Maitresinh/RDV4-a-simpler-yet-complete-laser-harp/GALVO_PURCHASE.md

# Choix du galvo

Acheter un kit complet, pas un moteur nu.

## Exigences

- boucle fermée ;
- 20 kpps minimum ;
- support mécanique inclus ;
- moteurs, deux drivers et alimentation appariés ;
- miroir adapté au rouge 650 nm ;
- schéma ou sérigraphie claire des entrées ;
- entrée X exploitable en simple-ended ou convertisseur différentiel documenté.

## À éviter

- galvo open-loop ;
- moteur de graveur ;
- scanner résonant ;
- driver sans alimentation ;
- annonce sans photo des connecteurs ;
- vitesse annoncée sans angle de référence.

## Informations à relever dès réception

- tension des alimentations ;
- tension d'entrée pleine échelle ;
- entrée simple ou différentielle ;
- brochage des connecteurs ;
- dimension et entraxe du bloc XY ;
- position neutre des miroirs ;
- méthode de maintien de l'axe Y au centre.
