Maitresinh/RDV4-a-simpler-yet-complete-laser-harp/hardware/kicad/RDV4_wiring.sch

## KiCad design hardware/kicad/RDV4_wiring.sch (2026-07-14)

Schematic: RDV4_wiring.sch

Parts:
C1: 100NF
D1: STATUS_LED
J1: TEENSY_4.0
J2: MCP4822_MODULE
J3: OPT101_MODULE
J4: VL53L4CD_MODULE
J5: LASER_650NM_TTL
J6: DUAL_BIPOLAR_INTERFACE
J7: GALVO_XY_DRIVER_INPUTS
J8: AUX_5V_INPUT
R1: 1K
R2: 10K
R3: 12K
R4: 22K
R6: 330R
SW1: E_STOP_NC
SW2: LID_NC
SW3: ARM

Notes on the sheet:
LOGIC / MIDI / SENSORS
LASER SAFETY AND GALVO
J2 pin 6 = LDAC -> GND VOUTA = X, VOUTB = Y neutral
Both switches wired using normally-closed contacts
J6 is a dual-channel 0..2.048 V to bipolar converter. Set X center and Y neutral to 0 V. Begin at +/-0.5 V. Do not ground differential inputs unless the driver manual permits it.
POWER / GROUND RULES
Teensy is powered by USB. Sensors and DAC use 3.3 V. Laser uses the safe 5 V chain. Galvo drivers and bipolar interface use their documented supplies. Keep power wiring away from OPT101. Connect signal grounds at one star point only when the galvo interface manual allows single-ended operation.
