Maitresinh/RDV4-a-simpler-yet-complete-laser-harp/firmware/include/config.h

#pragma once
#include <Arduino.h>

#ifndef ENABLE_HEIGHT_SENSOR
#define ENABLE_HEIGHT_SENSOR 1
#endif

#ifndef ENABLE_DIAGNOSTICS
#define ENABLE_DIAGNOSTICS 0
#endif

namespace cfg {

constexpr uint8_t PIN_ARM = 2;
constexpr uint8_t PIN_INTERLOCK_MON = 3;
constexpr uint8_t PIN_LASER_TTL = 6;
constexpr uint8_t PIN_STATUS_LED = 7;
constexpr uint8_t PIN_DAC_CS = 10;
constexpr uint8_t PIN_PHOTO = A1;

constexpr bool LASER_ACTIVE_HIGH = true;
constexpr bool HEIGHT_SENSOR_REQUIRED = true;
constexpr uint8_t MIDI_CHANNEL = 1;
constexpr uint8_t BASE_NOTE = 60; // C4, puis offsets -12/0/+12/+24
constexpr uint8_t MIDI_VELOCITY = 100;

constexpr uint16_t DAC_CENTER = 2048;
constexpr uint16_t DAC_Y_CENTER = 2048; // canal B, axe Y maintenu au neutre
constexpr uint16_t DAC_MIN = 1848;
constexpr uint16_t DAC_MAX = 2248;
constexpr uint32_t DAC_SPI_HZ = 20000000;

constexpr uint16_t GALVO_SETTLE_US = 90;
constexpr uint16_t LASER_RISE_US = 10;
constexpr uint16_t VISIBLE_DWELL_US = 22;
constexpr uint8_t ADC_SAMPLES_AMBIENT = 2;
constexpr uint8_t ADC_SAMPLES_LIT = 2;

constexpr uint8_t ATTACK_CONFIRM_FRAMES = 1;
constexpr uint8_t RELEASE_CONFIRM_FRAMES = 2;
constexpr uint8_t BASELINE_EMA_SHIFT = 5;
constexpr uint8_t BASELINE_WARMUP_SHIFT = 2;
constexpr uint16_t BASELINE_WARMUP_FRAMES = 32;

constexpr int16_t PER_BEAM_ON_DELTA[12] = {
  80,80,80,80,80,80,80,80,80,80,80,80
};
constexpr int16_t PER_BEAM_OFF_DELTA[12] = {
  48,48,48,48,48,48,48,48,48,48,48,48
};

constexpr uint16_t HEIGHT_MIN_MM = 80;
constexpr uint16_t HEIGHT_MAX_MM = 1100;
constexpr uint16_t HEIGHT_BOUNDARIES_MM[3] = {280, 520, 780};
constexpr int8_t HEIGHT_OCTAVE_SEMITONES[4] = {-12, 0, 12, 24};
constexpr uint16_t HEIGHT_HYSTERESIS_MM = 35;
constexpr uint32_t HEIGHT_TIMEOUT_MS = 800;
constexpr uint32_t HEIGHT_POLL_INTERVAL_US = 2000;

constexpr uint16_t CONTROL_DEBOUNCE_MS = 25;
constexpr uint32_t DIAGNOSTIC_INTERVAL_MS = 2000;

} // namespace cfg
