Maitresinh/RDV4-a-simpler-yet-complete-laser-harp/(commit log)

2026-07-14 Add board-first mechanics and reusable 3D catalog
2026-07-14 Add minimal modular BOM
    [BOM.csv]
2026-07-14 Add detailed wiring and interlock monitor
2026-07-14 Add calibration and latency procedure
2026-07-14 Add laser and electrical safety guide
2026-07-14 Add low-latency Teensy firmware
2026-07-14 Add staged hardware diagnostic sketch
2026-07-14 Add first power-on checklist
2026-07-14 Add board mounting layout
2026-07-14 Add KiCad module wiring schematic
    [RDV4_wiring.sch]
2026-07-14 Document KiCad wiring import and checks
2026-07-14 Add KiCad net label reference
    [net-labels.csv]
2026-07-14 Add AliExpress links and selection criteria to BOM
    [BOM.csv]
2026-07-14 Link KiCad wiring and document dual galvo channels
2026-07-14 Link KiCad wiring and AliExpress basket from README
2026-07-14 Simplify low-voltage wiring and remove WAGO kit
    [BOM.csv]
2026-07-14 Document simplified wiring without WAGO or generic JST kits
2026-07-14 Replace WAGO and generic JST kit with minimal wiring parts
2026-07-14 Prefer reusable adapted 3D parts in BOM
    [BOM.csv]
2026-07-14 Use existing adapted 3D mount instead of buying laser bracket
